chrishakim/lilBot/(list of files, drawings)

Other design files:
Manufacturing and schematics/Face.pcb
Manufacturing and schematics/Lil-Bot.pcb
